fsasm/f1tenth_sensors-interface-board/kicad/ba-imu/3d-001.png

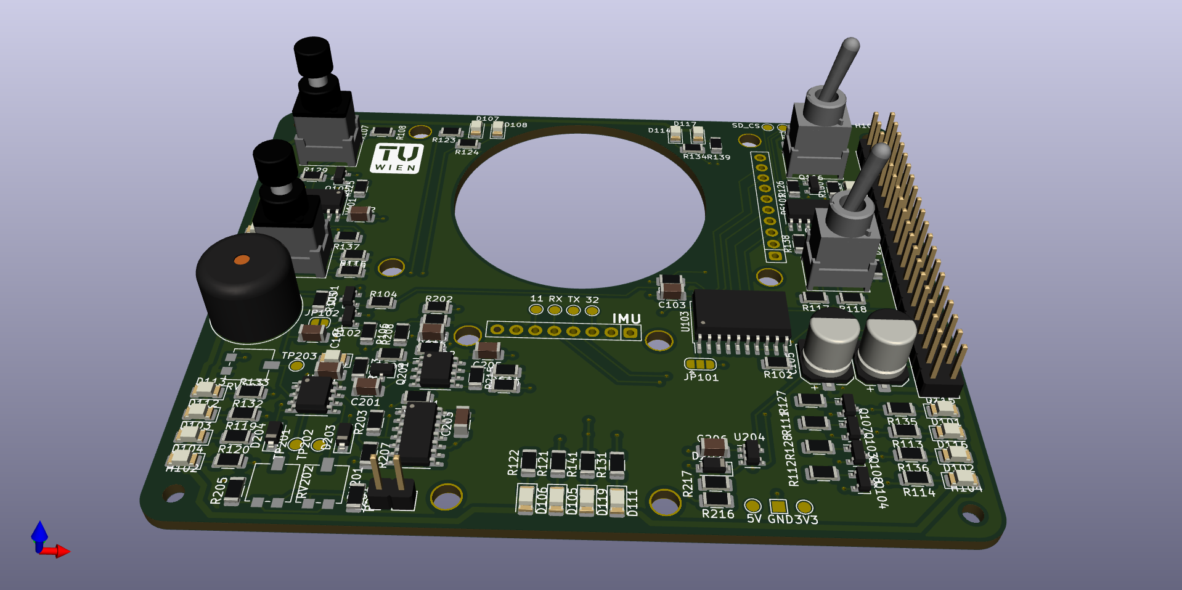
kicad/ba-imu/3d-001.png
