fsasm/f1tenth_sensors-interface-board/README.md

# f1tenth_sensors-interface-board
Extension board for F1tenth cars with sensors and interfaces for humans (LEDs, display, buttons, etc.)
