fsasm/f1tenth_sensors-interface-board/kicad/ba-imu/CFP2-1FC-AW.stp

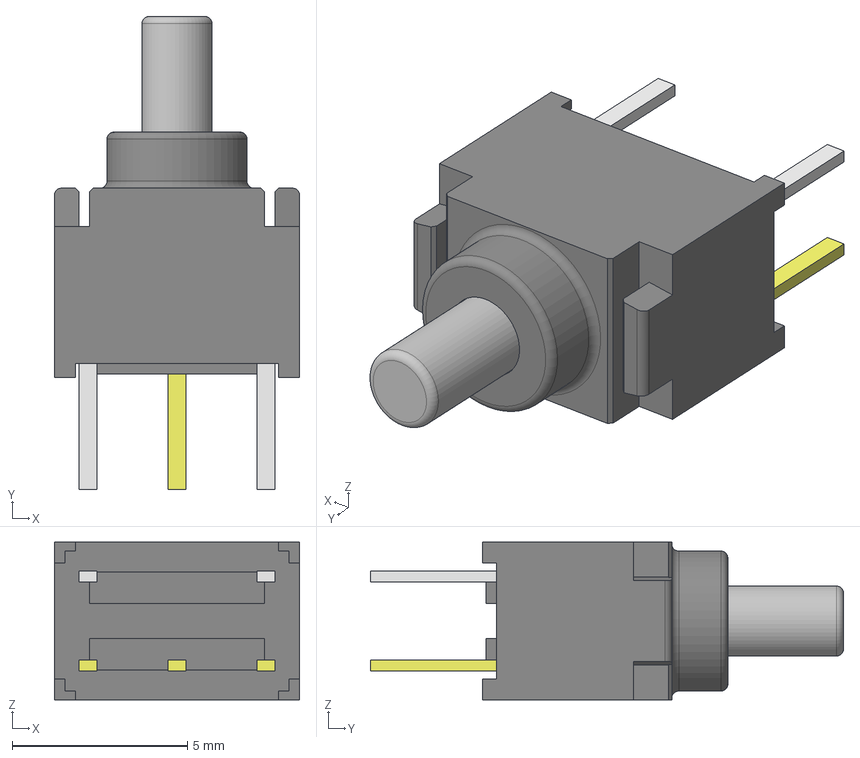
[picture p2: CAD file, 2022-10-10]
kicad/ba-imu/CFP2-1FC-AW.stp
7.00 x 13.5 x 4.50 mm
_2001FP_1_(CFT2)
_3007CFP_push_switch x 3
_3007CFT-2 x 2
_1002CFP-1
