fsasm/f1tenth_sensors-interface-board/kicad/BB15AP-FA.stp

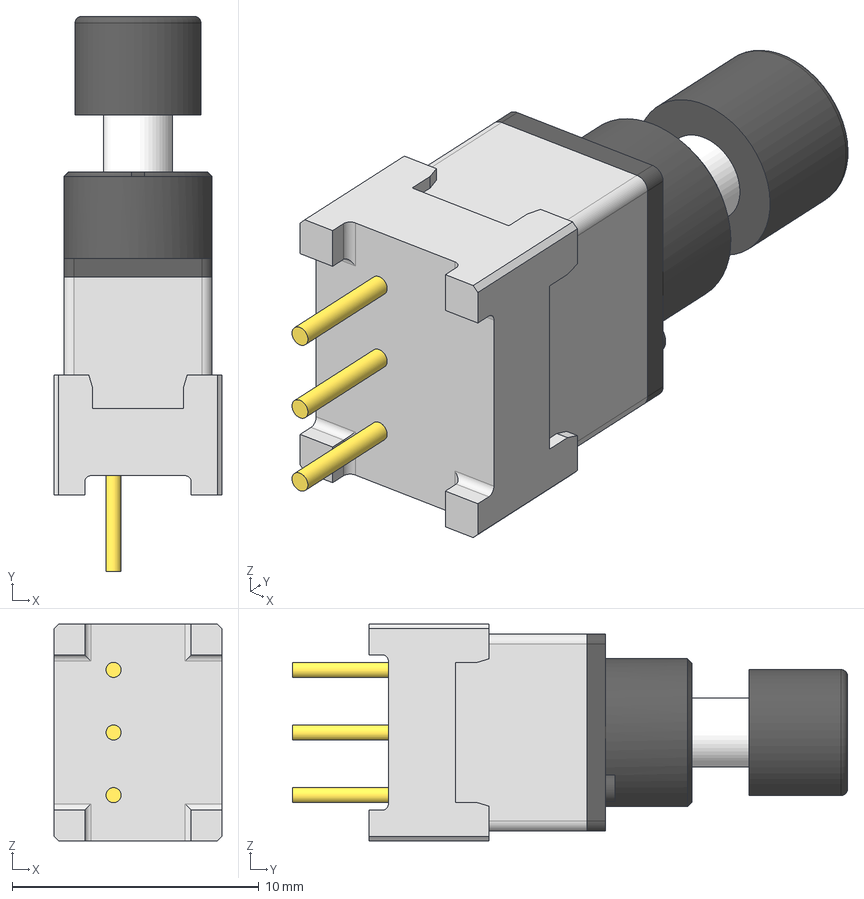
[picture p3: CAD file, 2022-10-10]
kicad/BB15AP-FA.stp
6.81 x 22.5 x 8.79 mm
_BB15-body
_BBA-plunger
_BB15P-terminal
_BB15P-body3
_BB-FA-cap
