fsasm/f1tenth_sensors-interface-board/kicad/B12AP.stp

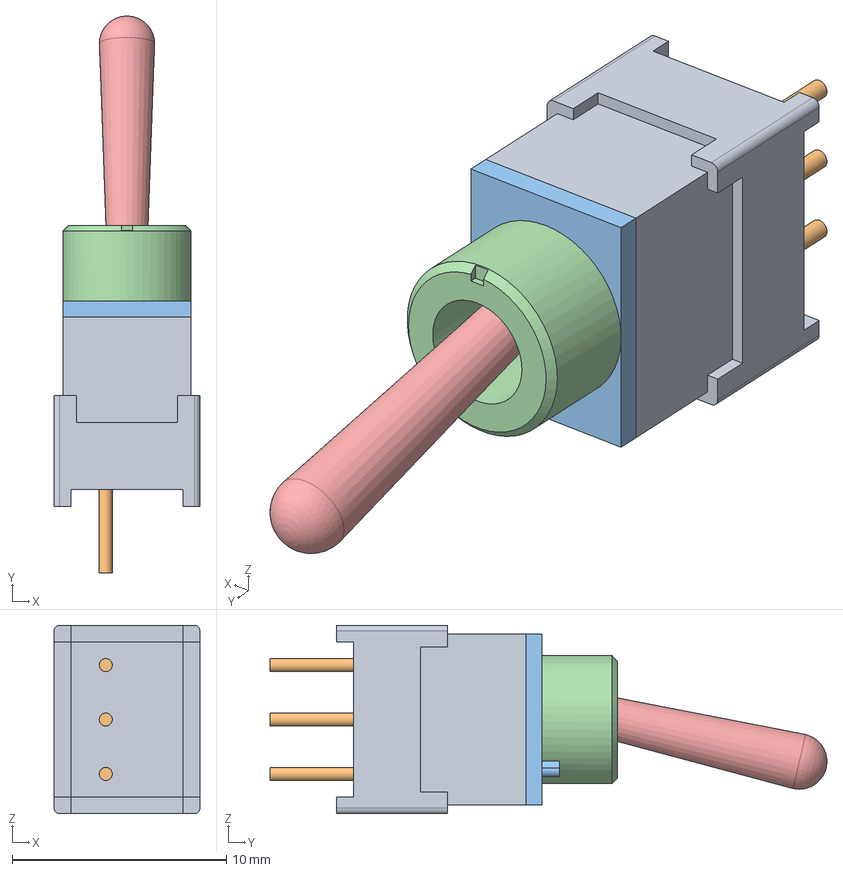
[picture p4: CAD file, 2022-10-10]
kicad/B12AP.stp
6.81 x 26.0 x 8.79 mm
_B12APbody
_B12APtrmnls
_B12APblack
_B12APbtoggl
_B12APtoggle
