fsasm/f1tenth_sensors-interface-board/kicad/ba-imu/CF-LD-1DC-AR2W.stp

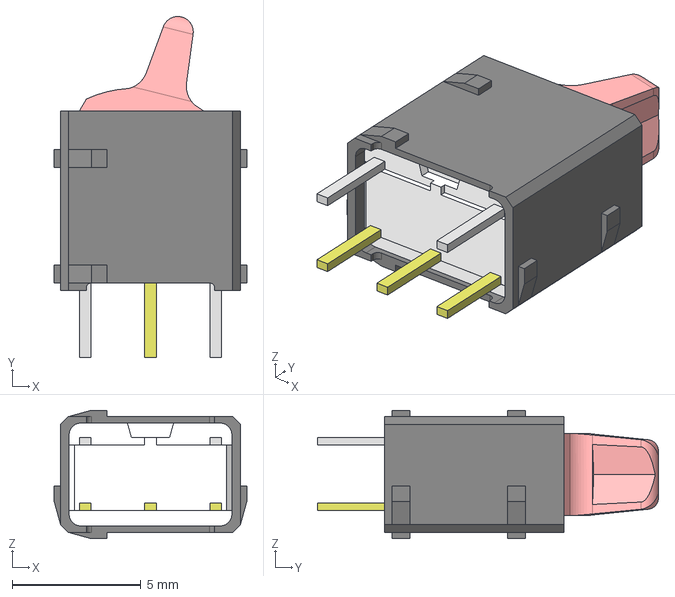
[picture p5: CAD file, 2022-10-10]
kicad/ba-imu/CF-LD-1DC-AR2W.stp
7.50 x 13.3 x 5.00 mm
_CF-LD_body (PC)
_CF-LD_Lever (1.00,0.50,0.50,0.00)
