fsasm/f1tenth_sensors-interface-board/(list of files, cad)

Other CAD files:
kicad/ba-imu/B12AP.stp
