fsasm/f1tenth_sensors-interface-board/kicad/ba-imu/ba-imu.pdf

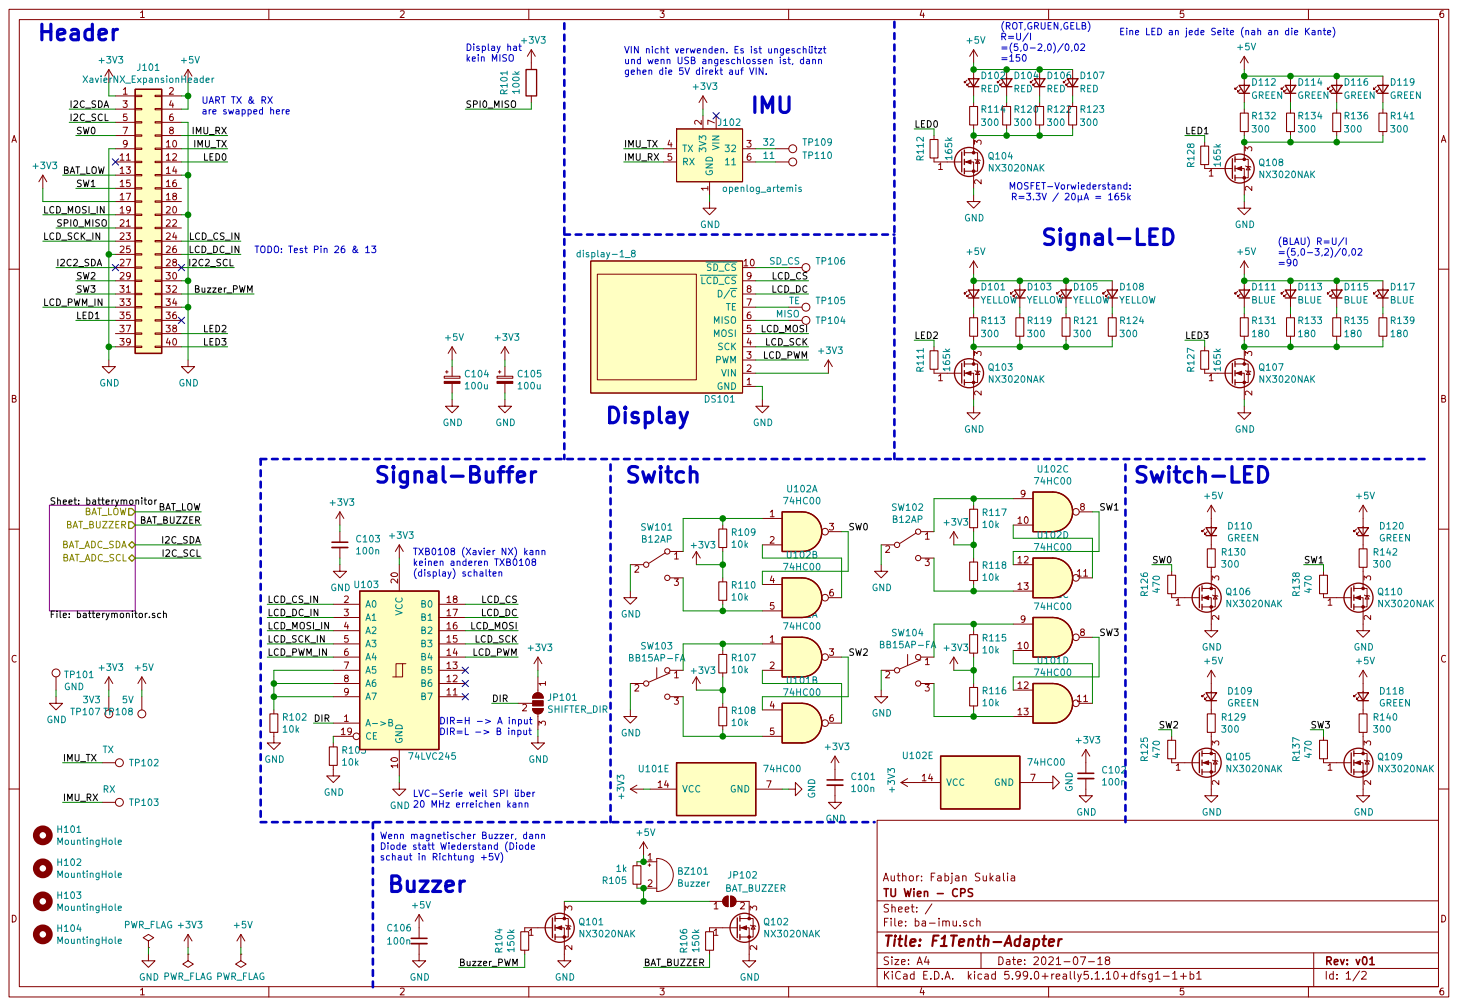
[picture p6: page 1]

Eine LED an jede Seite (nah an die Kante)

VIN nicht verwenden. Es ist ungeschützt
und wenn USB angeschlossen ist, dann
gehen die 5V direkt auf VIN.

=(5,0-3,2)/0,02 =90 TXB0108 (Xavier NX) kann keinen anderen TXB0108

LVC-Serie weil SPI über 20 MHz erreichen kann

Wenn magnetischer Buzzer, dann
Diode statt Wiederstand (Diode
schaut in Richtung +5V)
Buzzer

Author: Fabjan Sukalia
Id: 1/2 Title: F1Tenth-Adapter File: ba-imu.sch Sheet: / TU Wien - CPS

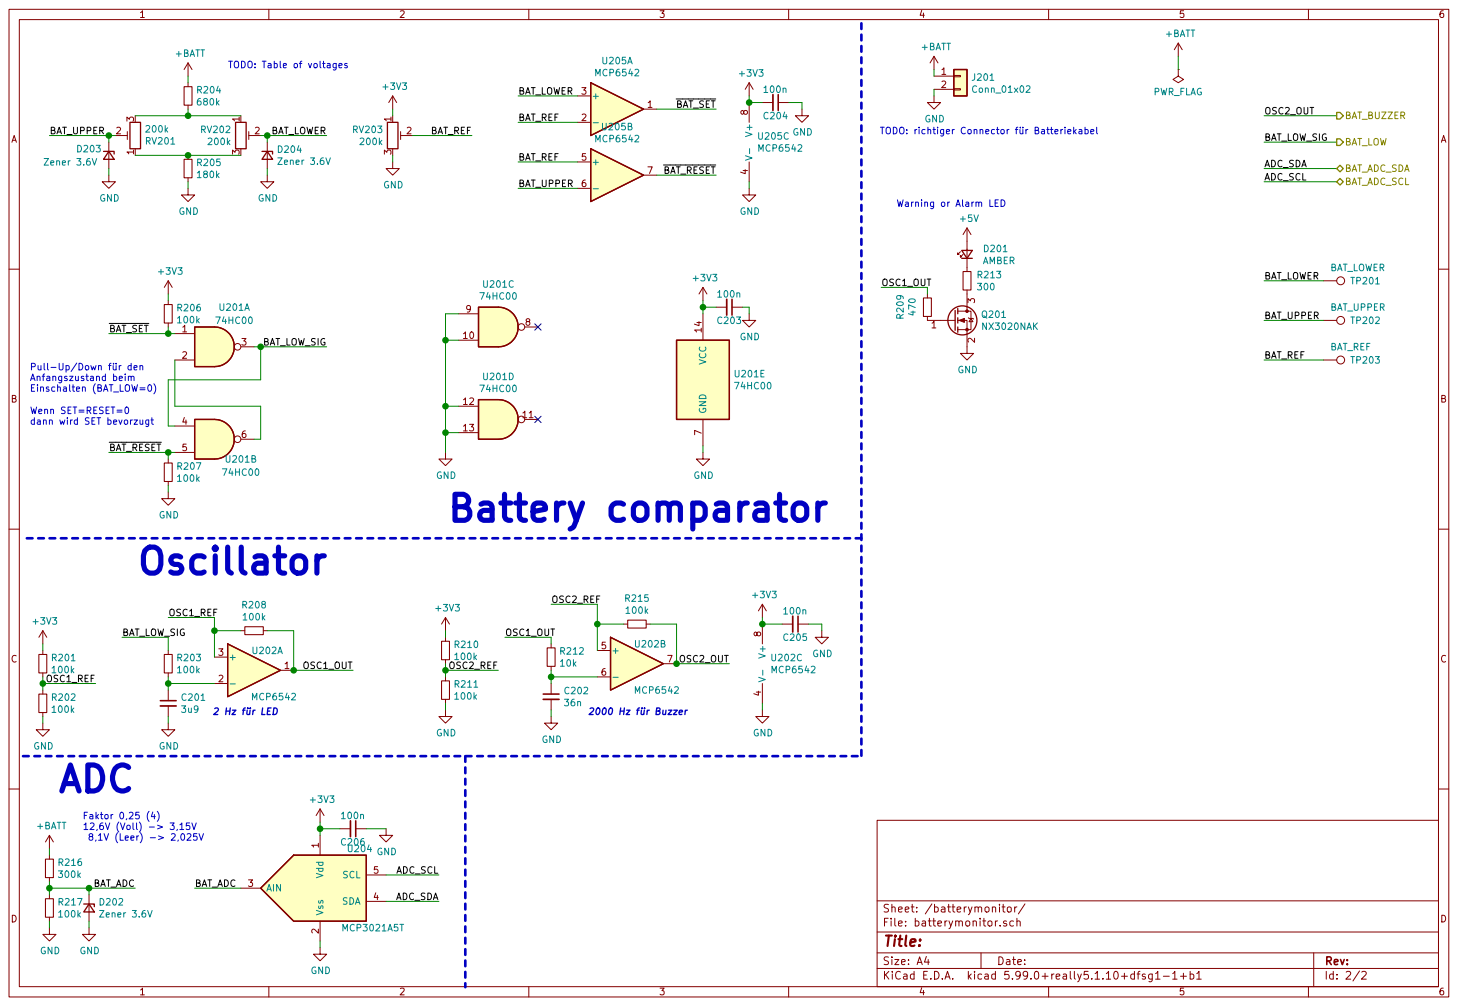
[picture p7: page 2]

TODO: Table of voltages

TODO: richtiger Connector für Batteriekabel

Warning or Alarm LED

Anfangszustand beim
Einschalten (BAT_LOW=0)
Wenn SET=RESET=0
dann wird SET bevorzugt

1 Vss 2 AIN 3 SDA 4 SCL 5 U204 MCP3021A5T
