fsasm/f1tenth_sensors-interface-board/kicad/ba-imu/batterymonitor-batterymonitor.pdf

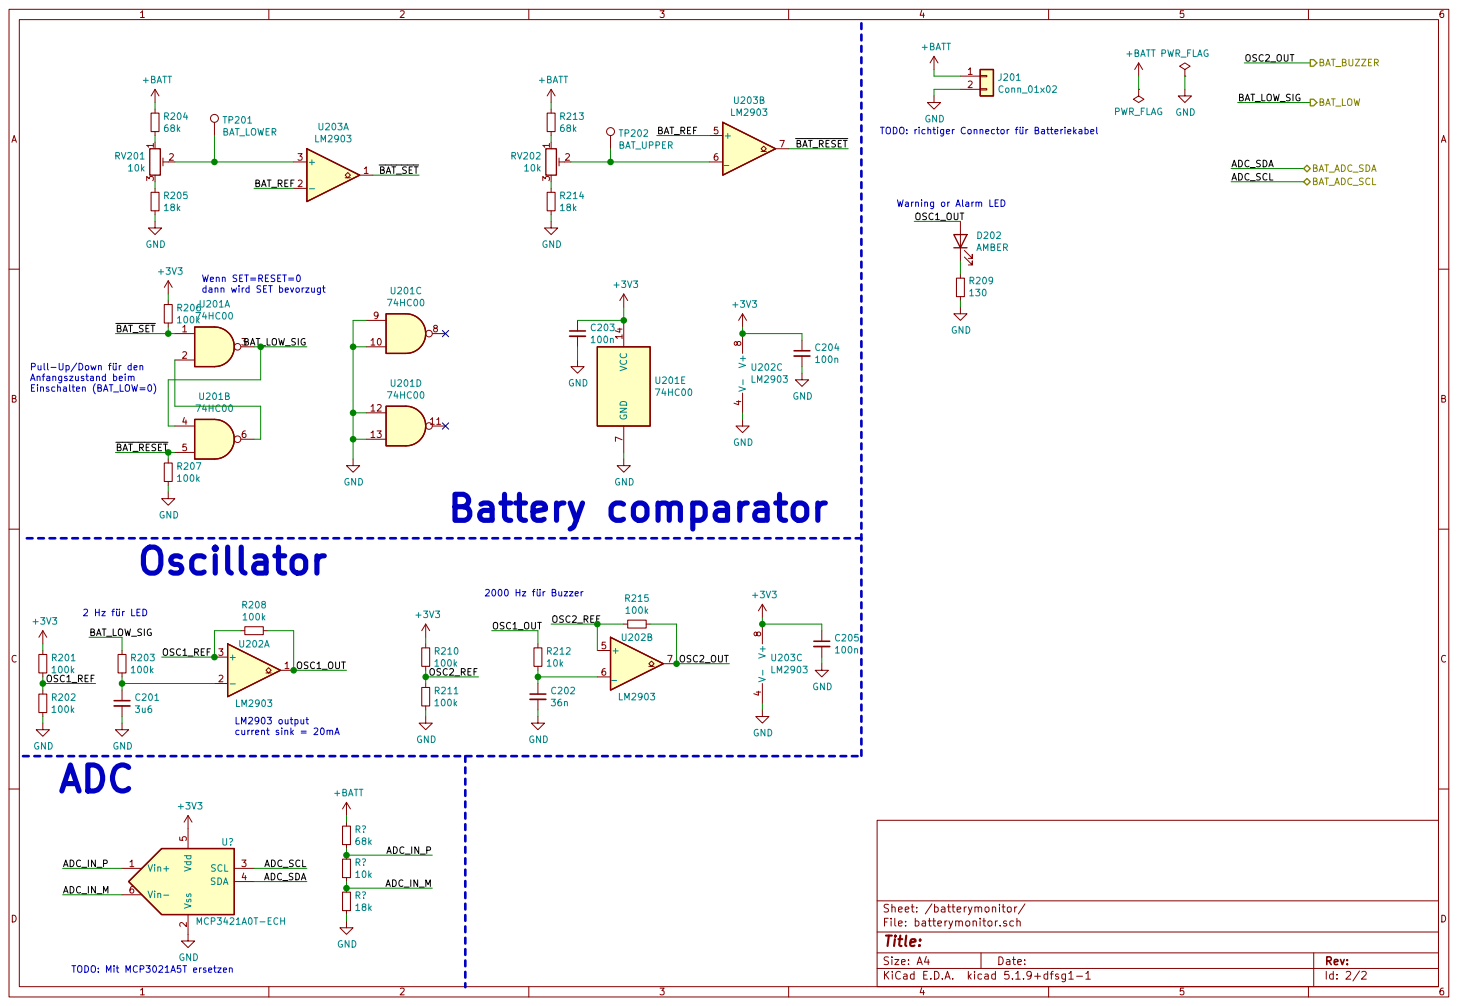
[picture p8: page 1]

TODO: richtiger Connector für Batteriekabel

Warning or Alarm LED

Wenn SET=RESET=0
dann wird SET bevorzugt

2000 Hz für Buzzer Pull-Up/Down für den
Anfangszustand beim
Einschalten (BAT_LOW=0)
