fsasm/f1tenth_sensors-interface-board/kicad/ba-imu/ba-imu.kicad_pcb

## KiCad design kicad/ba-imu/ba-imu.kicad_pcb (2022-10-10)

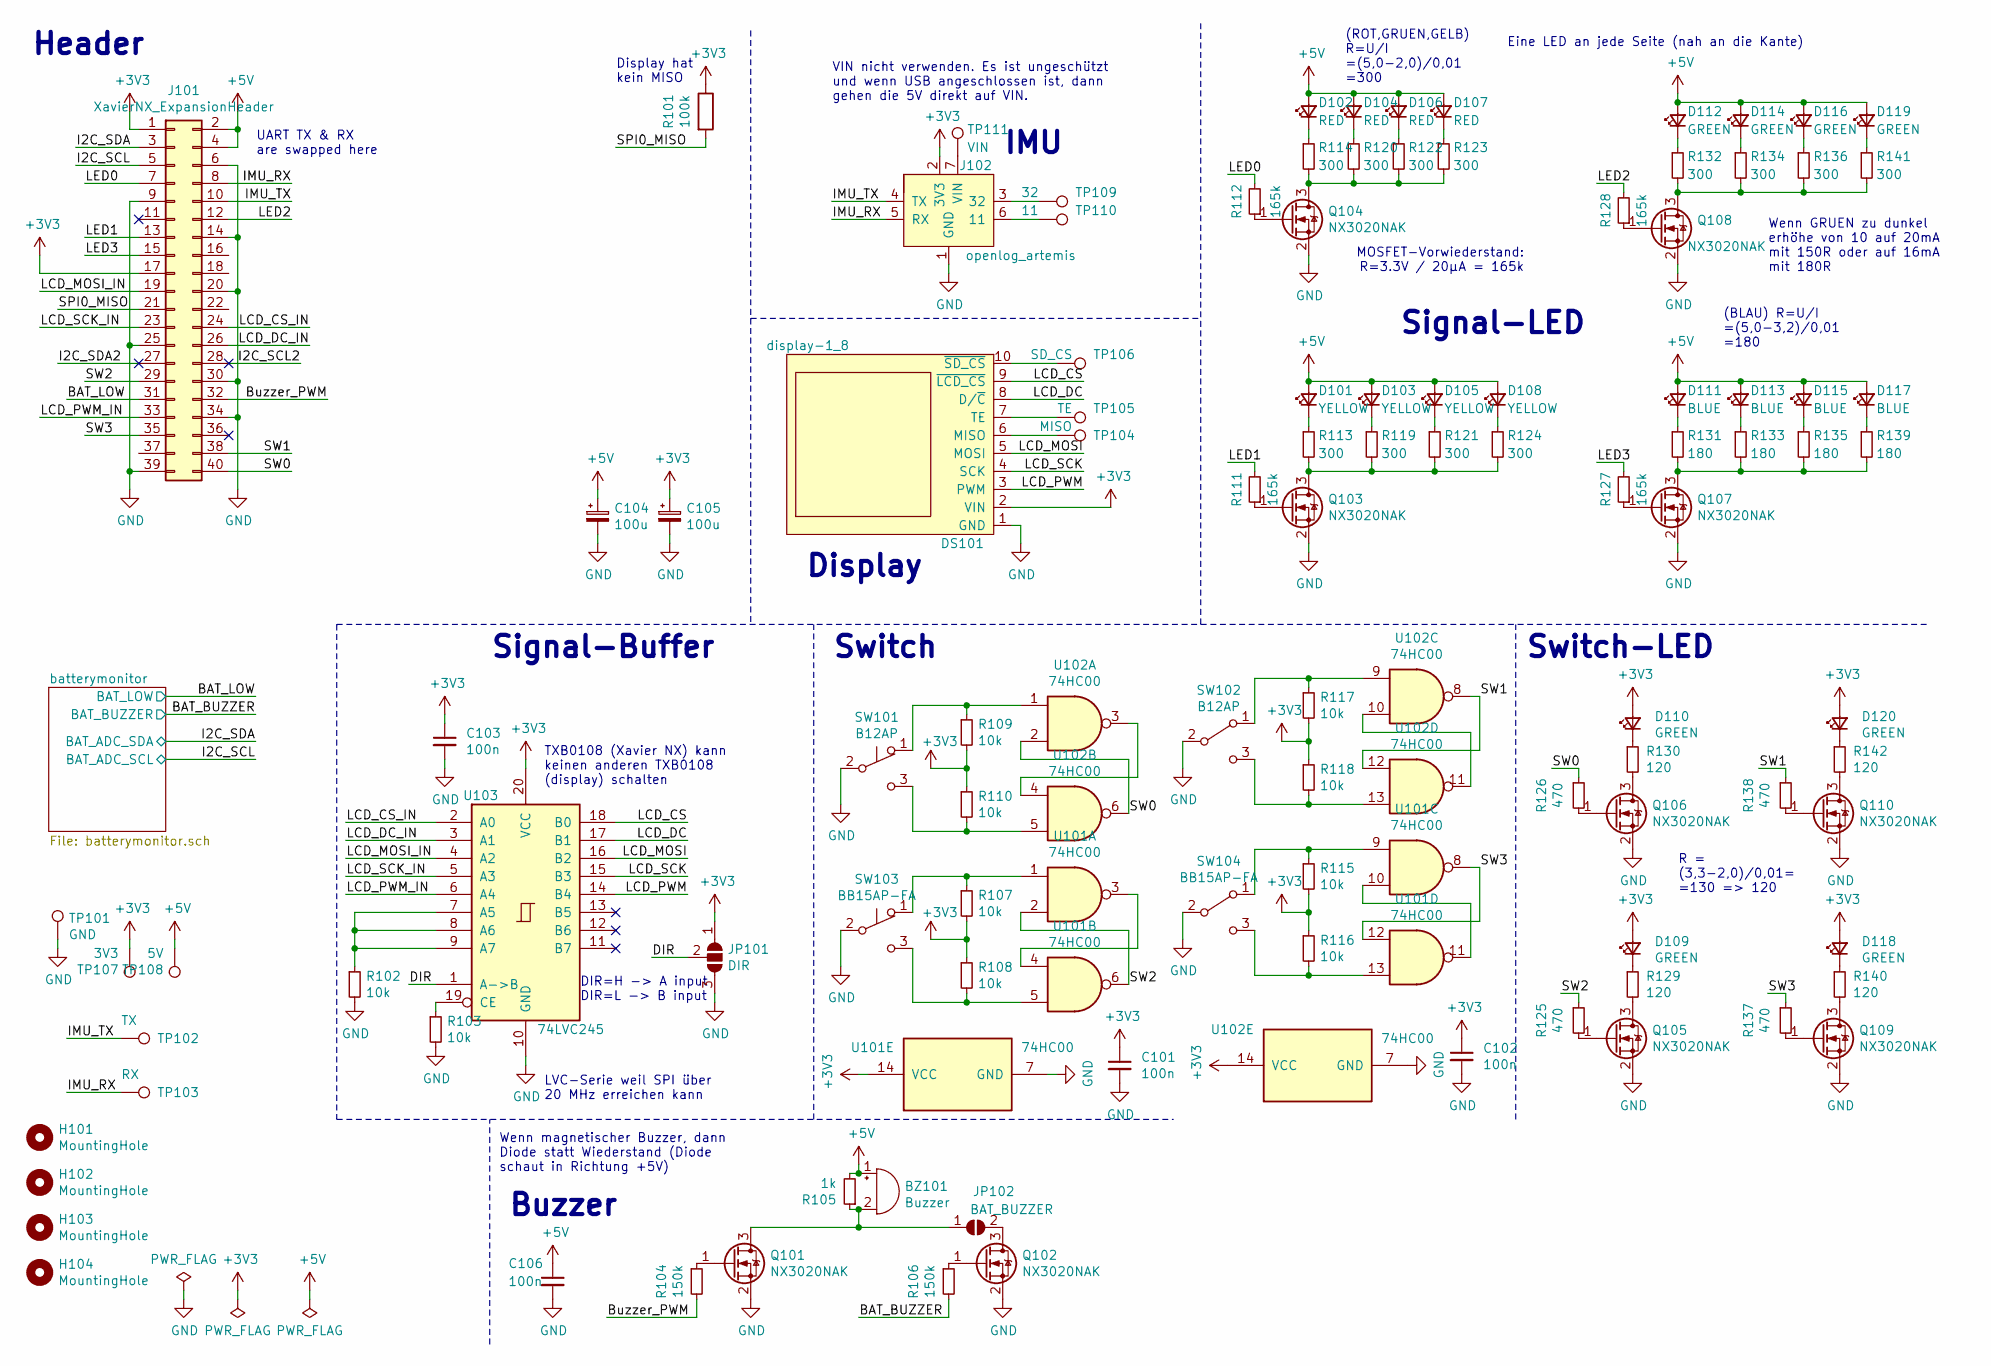
[picture p9: schematic ba-imu.sch, F1Tenth-Adapter]

Parts:
BZ101: Buzzer; Buzzer_TDK_PS1240P02BT_D12.2mm_H6.5mm; MPN PS1240P02BT; Digi-Key PN 445-2525-1-ND
C101, C102, C103, C106: 100n; C_1206_3216Metric
C104, C105: 100u; CP_Elec_6.3x7.7
D101, D103, D105, D108: YELLOW; LED_1206_3216Metric; MPN 156120YS75000; Digi-Key PN 732-5034-1-ND
D102, D104, D106, D107: RED; LED_1206_3216Metric; MPN 156120RS75000; Digi-Key PN 732-5030-1-ND
D109, D110, D112, D114, D116, D118, D119, D120: GREEN; LED_1206_3216Metric; MPN HSMQ-C150; Digi-Key PN 516-1444-1-ND
D111, D113, D115, D117: BLUE; LED_1206_3216Metric; MPN 156125BS75000; Digi-Key PN 732-13392-1-ND
DS101: display-1_8; display_SIP-10
H101, H102, H103, H104: MountingHole; MountingHole_2.5mm
J101: XavierNX_ExpansionHeader; PinHeader_2x20_P2.54mm_Vertical
J102: openlog_artemis; imu_SIP-7
JP101: DIR; SolderJumper-3_P1.3mm_Open_RoundedPad1.0x1.5mm
JP102: BAT_BUZZER; SolderJumper-2_P1.3mm_Open_RoundedPad1.0x1.5mm
Q101, Q102, Q103, Q104, Q105, Q106, Q107, Q108, Q109, Q110: NX3020NAK; SOT-23; MPN NX3020NAK; Digi-Key PN 1727-1285-1-ND
R101: 100k; R_1206_3216Metric
R102, R103, R107, R108, R109, R110, R115, R116, R117, R118: 10k; R_1206_3216Metric
R104, R106: 150k; R_1206_3216Metric
R105: 1k; R_1206_3216Metric
R111, R112, R127, R128: 165k; R_1206_3216Metric
R113, R114, R119, R120, R121, R122, R123, R124, R132, R134, R136, R141: 300; R_1206_3216Metric
R125, R126, R137, R138: 470; R_1206_3216Metric
R129, R130, R140, R142: 120; R_1206_3216Metric
R131, R133, R135, R139: 180; R_1206_3216Metric
SW101: B12AP; SW_Nidec_CFP2-1FC-AW; MPN B12AP; Digi-Key PN 360-1012-ND
SW102: B12AP; SW_Nidec_CF-LD-1DC-AR2W; MPN B12AP; Digi-Key PN 360-1012-ND
SW103: BB15AP-FA; SW_Nidec_CFP2-1FC-AW; MPN BB15AP-FA; Digi-Key PN 360-3753-ND
SW104: BB15AP-FA; SW_Nidec_CF-LD-1DC-AR2W; MPN BB15AP-FA; Digi-Key PN 360-3753-ND
TP101: GND; TestPoint_Pad_1.5x1.5mm
TP102: TX; TestPoint_Pad_D1.5mm
TP103: RX; TestPoint_Pad_D1.5mm
TP104: MISO; TestPoint_Pad_D1.5mm
TP105: TE; TestPoint_Pad_D1.5mm
TP106: SD_CS; TestPoint_Pad_D1.5mm
TP107: 3V3; TestPoint_Pad_D1.5mm
TP108: 5V; TestPoint_Pad_D1.5mm
TP109: 32; TestPoint_Pad_D1.5mm
TP110: 11; TestPoint_Pad_D1.5mm
TP111: VIN; TestPoint_Pad_D1.5mm
U101, U102: 74HC00; SOIC-14_3.9x8.7mm_P1.27mm; MPN SN74HC00DE4; Digi-Key PN 296-52930-ND
U103: 74LVC245; SOIC-20W_7.5x12.8mm_P1.27mm; MPN SN74LVC245ADW; Digi-Key PN 296-1232-5-ND

Connections:
+3V3: C101.1, C102.1, C103.1, C105.1, D109.2 (A), D110.2 (A), D118.2 (A), D120.2 (A), DS101.2 (VIN), J101.1, J101.17, J102.2 (3V3), JP101.1 (A), R101.1, R107.2, R108.1, R109.2, R110.1, R115.2, R116.1, R117.2, R118.1, TP107.1, U101.14 (VCC), U102.14 (VCC), U103.20 (VCC); also elsewhere on the board
+5V: BZ101.1 (-), C104.1, C106.1, D101.2 (A), D102.2 (A), D103.2 (A), D104.2 (A), D105.2 (A), D106.2 (A), D107.2 (A), D108.2 (A), D111.2 (A), D112.2 (A), D113.2 (A), D114.2 (A), D115.2 (A), D116.2 (A), D117.2 (A), D119.2 (A), J101.2, J101.4, R105.2, TP108.1
/BAT_BUZZER: R106.2; also elsewhere on the board
/BAT_LOW: J101.31; also elsewhere on the board
/Buzzer_PWM: J101.32, R104.2
/DIR: JP101.2 (C), U103.1 (A->B)
/I2C_SCL: J101.5; also elsewhere on the board
/I2C_SCL2: J101.28
/I2C_SDA: J101.3; also elsewhere on the board
/I2C_SDA2: J101.27
/IMU_RX: J101.8, J102.5 (RX), TP103.1
/IMU_TX: J101.10, J102.4 (TX), TP102.1
/LCD_CS: DS101.9 (~LCD_CS), U103.18 (B0)
/LCD_CS_IN: J101.24, U103.2 (A0)
/LCD_DC: DS101.8 (D/~C), U103.17 (B1)
/LCD_DC_IN: J101.26, U103.3 (A1)
/LCD_MOSI: DS101.5 (MOSI), U103.16 (B2)
/LCD_MOSI_IN: J101.19, U103.4 (A2)
/LCD_PWM: DS101.3 (PWM), U103.14 (B4)
/LCD_PWM_IN: J101.33, U103.6 (A4)
/LCD_SCK: DS101.4 (SCK), U103.15 (B3)
/LCD_SCK_IN: J101.23, U103.5 (A3)
/LED0: J101.7, R112.2
/LED1: J101.13, R111.2
/LED2: J101.12, R128.2
/LED3: J101.15, R127.2
/SPI0_MISO: J101.21, R101.2
/SW0: J101.40, R126.1, U102.2, U102.6
/SW1: J101.38, R138.1, U102.8, U102.12
/SW2: J101.29, R125.1, U101.2, U101.6
/SW3: J101.35, R137.1, U101.8, U101.12
GND: C101.2, C102.2, C103.2, C104.2, C105.2, C106.2, DS101.1 (GND), J101.6, J101.9, J101.14, J101.20, J101.25, J101.30, J101.34, J101.39, J102.1 (GND), JP101.3 (B), Q101.2 (S), Q102.2 (S), Q103.2 (S), Q104.2 (S), Q105.2 (S), Q106.2 (S), Q107.2 (S), Q108.2 (S), Q109.2 (S), Q110.2 (S), R102.2, R103.2, SW101.2 (B), SW102.2 (B), SW103.2 (B), SW104.2 (B), TP101.1, U101.7 (GND), U102.7 (GND), U103.10 (GND); also elsewhere on the board
unnamed: BZ101.2 (+), JP102.1 (A), Q101.3 (D), R105.1
unnamed: D101.1 (K), R113.1
unnamed: D102.1 (K), R114.1
unnamed: D103.1 (K), R119.1
unnamed: D104.1 (K), R120.1
unnamed: D105.1 (K), R121.1
unnamed: D106.1 (K), R122.1
unnamed: D107.1 (K), R123.1
unnamed: D108.1 (K), R124.1
unnamed: D109.1 (K), R129.1
unnamed: D110.1 (K), R130.1
unnamed: D111.1 (K), R131.1
unnamed: D112.1 (K), R132.1
unnamed: D113.1 (K), R133.1
unnamed: D114.1 (K), R134.1
unnamed: D115.1 (K), R135.1
unnamed: D116.1 (K), R136.1
unnamed: D117.1 (K), R139.1
unnamed: D118.1 (K), R140.1
unnamed: D119.1 (K), R141.1
unnamed: D120.1 (K), R142.1
unnamed: DS101.6 (MISO), TP104.1
unnamed: DS101.7 (TE), TP105.1
unnamed: DS101.10 (~SD_CS), TP106.1
unnamed: J102.3 (32), TP109.1
unnamed: J102.6 (11), TP110.1
unnamed: J102.7 (VIN), TP111.1
unnamed: JP102.2 (B), Q102.3 (D)
unnamed: Q101.1 (G), R104.1
unnamed: Q102.1 (G), R106.1
unnamed: Q103.1 (G), R111.1
unnamed: Q103.3 (D), R113.2, R119.2, R121.2, R124.2
unnamed: Q104.1 (G), R112.1
unnamed: Q104.3 (D), R114.2, R120.2, R122.2, R123.2
unnamed: Q105.1 (G), R125.2
unnamed: Q105.3 (D), R129.2
unnamed: Q106.1 (G), R126.2
unnamed: Q106.3 (D), R130.2
unnamed: Q107.1 (G), R127.1
unnamed: Q107.3 (D), R131.2, R133.2, R135.2, R139.2
unnamed: Q108.1 (G), R128.1
unnamed: Q108.3 (D), R132.2, R134.2, R136.2, R141.2
unnamed: Q109.1 (G), R137.2
unnamed: Q109.3 (D), R140.2
unnamed: Q110.1 (G), R138.2
unnamed: Q110.3 (D), R142.2
unnamed: R102.1, U103.7 (A5), U103.8 (A6), U103.9 (A7)
unnamed: R103.1, U103.19 (CE)
unnamed: R107.1, SW103.1 (A), U101.1
unnamed: R108.2, SW103.3 (C), U101.5
unnamed: R109.1, SW101.1 (A), U102.1
unnamed: R110.2, SW101.3 (C), U102.5
unnamed: R115.1, SW104.1 (A), U101.9
unnamed: R116.2, SW104.3 (C), U101.13
unnamed: R117.1, SW102.1 (A), U102.9
unnamed: R118.2, SW102.3 (C), U102.13
unnamed: U101.3, U101.4
unnamed: U101.10, U101.11
unnamed: U102.3, U102.4
unnamed: U102.10, U102.11

Notes on the sheet:
(ROT,GRUEN,GELB) R=U/I =(5,0-2,0)/0,01 =300
Wenn magnetischer Buzzer, dann Diode statt Wiederstand (Diode schaut in Richtung +5V)
VIN nicht verwenden. Es ist ungeschützt und wenn USB angeschlossen ist, dann gehen die 5V direkt auf VIN.
Eine LED an jede Seite (nah an die Kante)
DIR=H -> A input DIR=L -> B input
TXB0108 (Xavier NX) kann keinen anderen TXB0108 (display) schalten
(BLAU) R=U/I =(5,0-3,2)/0,01 =180
UART TX & RX are swapped here
Switch-LED
Switch
Buzzer
Signal-LED
LVC-Serie weil SPI über 20 MHz erreichen kann
Signal-Buffer
IMU
Display
Header
Display hat kein MISO
R = (3,3-2,0)/0,01= =130 => 120
Wenn GRUEN zu dunkel erhöhe von 10 auf 20mA mit 150R oder auf 16mA mit 180R
MOSFET-Vorwiederstand: R=3.3V / 20µA = 165k

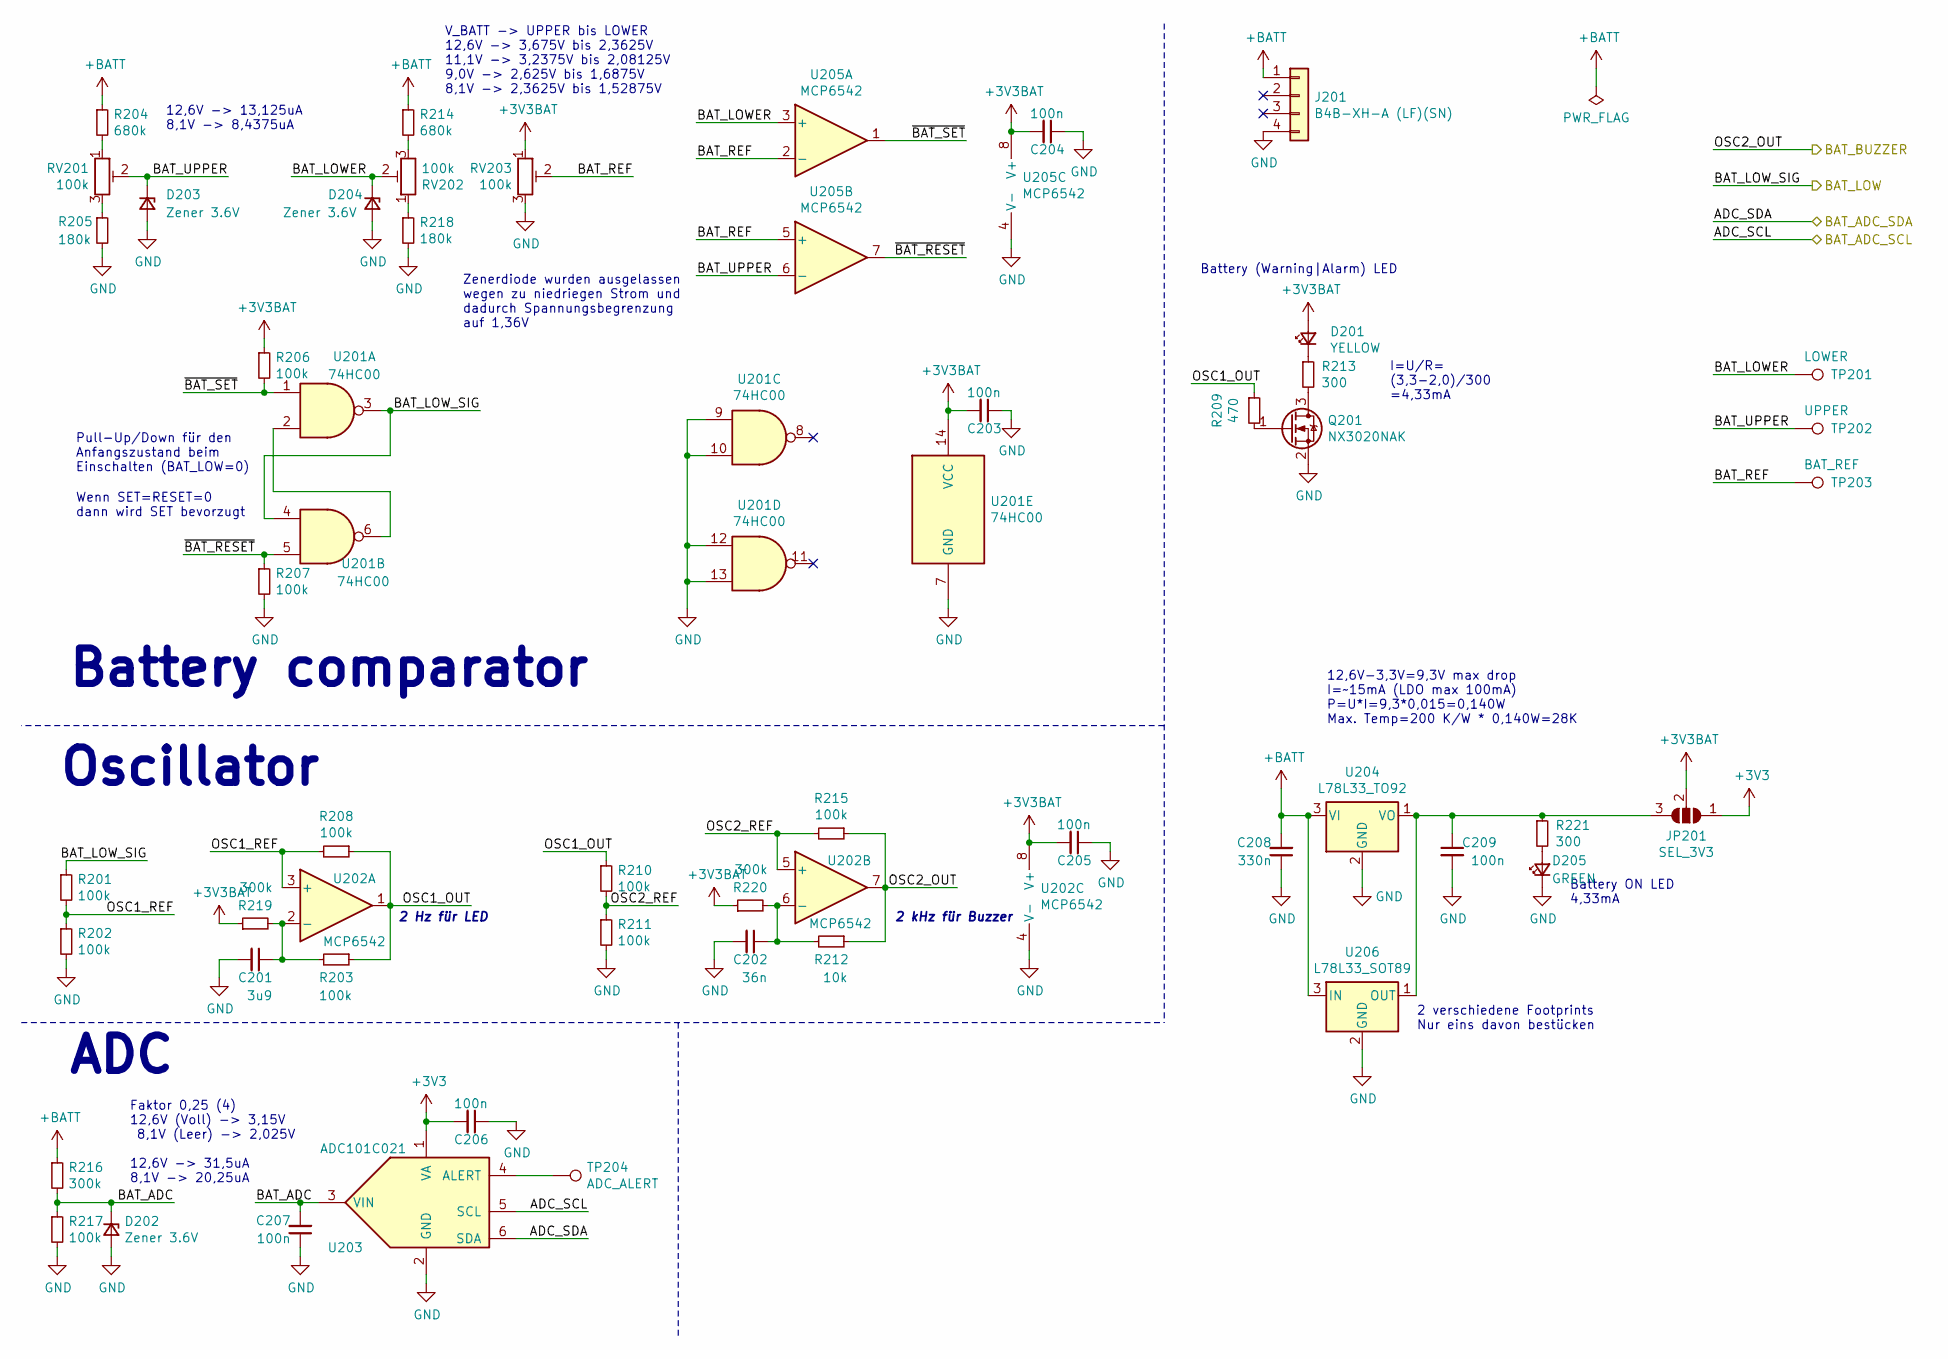
[picture p10: schematic batterymonitor.sch]

Parts:
C201: 3u9; C_1206_3216Metric
C202: 36n; C_1206_3216Metric
C203, C204, C205, C206, C207, C209: 100n; C_1206_3216Metric
C208: 330n; C_1206_3216Metric
D201: YELLOW; LED_1206_3216Metric; MPN 156120YS75000; Digi-Key PN 732-5034-1-ND
D202, D203, D204: Zener 3.6V; D_SOD-123; MPN MMSZ5227B-TP; Mouser PN 833-MMSZ5227B-TP
D205: GREEN; LED_1206_3216Metric; MPN 156120YS75000; Digi-Key PN 732-5034-1-ND
J201: B4B-XH-A (LF)(SN); JST_XH_B4B-XH-A_1x04_P2.50mm_Vertical; MPN B4B-XH-A(LF)(SN); Digi-Key PN 455-2249-ND
JP201: SEL_3V3; SolderJumper-3_P1.3mm_Open_RoundedPad1.0x1.5mm
Q201: NX3020NAK; SOT-23; MPN NX3020NAK; Digi-Key PN 1727-1285-1-ND
R201, R202, R203, R206, R207, R208, R210, R211, R215, R217: 100k; R_1206_3216Metric
R204, R214: 680k; R_1206_3216Metric
R205, R218: 180k; R_1206_3216Metric
R209: 470; R_1206_3216Metric
R212: 10k; R_1206_3216Metric
R213, R221: 300; R_1206_3216Metric
R216, R219, R220: 300k; R_1206_3216Metric
RV201, RV202, RV203: 100k; Potentiometer_Vishay_TS53YL_Vertical; MPN TS53YL204MR10; Digi-Key PN TS53YL-200KCT-ND
TP201: LOWER; TestPoint_Pad_D1.5mm
TP202: UPPER; TestPoint_Pad_D1.5mm
TP203: BAT_REF; TestPoint_Pad_D1.5mm
TP204: ADC_ALERT; TestPoint_Pad_D1.5mm
U201: 74HC00; SOIC-14_3.9x8.7mm_P1.27mm; MPN SN74HC00DE4; Digi-Key PN 296-52930-ND
U202, U205: MCP6542; SOIC-8_3.9x4.9mm_P1.27mm; MPN MCP6542-I/SN; Digi-Key PN MCP6542-I/SN-ND
U203: ADC101C021; SOT-23-6
U204: L78L33_TO92; TO-92_Inline
U206: L78L33_SOT89; SOT-89-3

Connections:
+3V3: C206.2, JP201.1 (A), U203.1 (VA); also elsewhere on the board
+3V3BAT: C203.2, C204.2, C205.2, D201.2 (A), JP201.2 (C), R206.1, R219.1, R220.1, RV203.1, U201.14 (VCC), U202.8 (V+), U205.8 (V+)
+BATT: C208.2, J201.1, R204.1, R214.1, R216.1, U204.3 (VI), U206.3 (IN)
/BAT_BUZZER: R212.1, R215.1, U202.7; also elsewhere on the board
/BAT_LOW: R201.1, U201.3, U201.4; also elsewhere on the board
/I2C_SCL: U203.5 (SCL); also elsewhere on the board
/I2C_SDA: U203.6 (SDA); also elsewhere on the board
/batterymonitor/BAT_ADC: C207.2, D202.1 (K), R216.2, R217.1, U203.3 (VIN)
/batterymonitor/BAT_LOWER: D204.1 (K), RV202.2, TP201.1, U205.3 (+)
/batterymonitor/BAT_REF: RV203.2, TP203.1, U205.2 (-), U205.5 (+)
/batterymonitor/BAT_UPPER: D203.1 (K), RV201.2, TP202.1, U205.6 (-)
/batterymonitor/OSC1_OUT: R203.1, R208.1, R209.1, R210.1, U202.1
/batterymonitor/OSC1_REF: R201.2, R202.1, R208.2, U202.3 (+)
/batterymonitor/OSC2_REF: R210.2, R211.1, R215.2, U202.5 (+)
/batterymonitor/~BAT_RESET: R207.1, U201.5, U205.7
/batterymonitor/~BAT_SET: R206.2, U201.1, U205.1
GND: C201.2, C202.2, C203.1, C204.1, C205.1, C206.1, C207.1, C208.1, C209.2, D202.2 (A), D203.2 (A), D204.2 (A), D205.1 (K), J201.4, Q201.2 (S), R202.2, R205.2, R207.2, R211.2, R217.2, R218.2, RV203.3, U201.7 (GND), U201.9, U201.10, U201.12, U201.13, U202.4 (V-), U203.2 (GND), U204.2 (GND), U205.4 (V-), U206.2 (GND); also elsewhere on the board
unnamed: C201.1, R203.2, R219.2, U202.2 (-)
unnamed: C202.1, R212.2, R220.2, U202.6 (-)
unnamed: C209.1, JP201.3 (B), R221.1, U204.1 (VO), U206.1 (OUT)
unnamed: D201.1 (K), R213.1
unnamed: D205.2 (A), R221.2
unnamed: Q201.1 (G), R209.2
unnamed: Q201.3 (D), R213.2
unnamed: R204.2, RV201.1
unnamed: R205.1, RV201.3
unnamed: R214.2, RV202.3
unnamed: R218.1, RV202.1
unnamed: TP204.1, U203.4 (ALERT)
unnamed: U201.2, U201.6

Notes on the sheet:
Pull-Up/Down für den Anfangszustand beim Einschalten (BAT_LOW=0)
Battery comparator
Oscillator
Wenn SET=RESET=0 dann wird SET bevorzugt
2 kHz für Buzzer
Battery (Warning|Alarm) LED
ADC
Faktor 0,25 (4) 12,6V (Voll) -> 3,15V 8,1V (Leer) -> 2,025V 12,6V -> 31,5uA 8,1V -> 20,25uA
V_BATT -> UPPER bis LOWER 12,6V -> 3,675V bis 2,3625V 11,1V -> 3,2375V bis 2,08125V 9,0V -> 2,625V bis 1,6875V 8,1V -> 2,3625V bis 1,52875V
2 Hz für LED
12,6V -> 13,125uA 8,1V -> 8,4375uA
Zenerdiode wurden ausgelassen wegen zu niedriegen Strom und dadurch Spannungsbegrenzung auf 1,36V
Battery ON LED 4,33mA
I=U/R= (3,3-2,0)/300 =4,33mA
2 verschiedene Footprints Nur eins davon bestücken
12,6V-3,3V=9,3V max drop I=~~15mA (LDO max 100mA) P=U*I=9,3*0,015=0,140W Max. Temp=200 K/W * 0,140W=28K

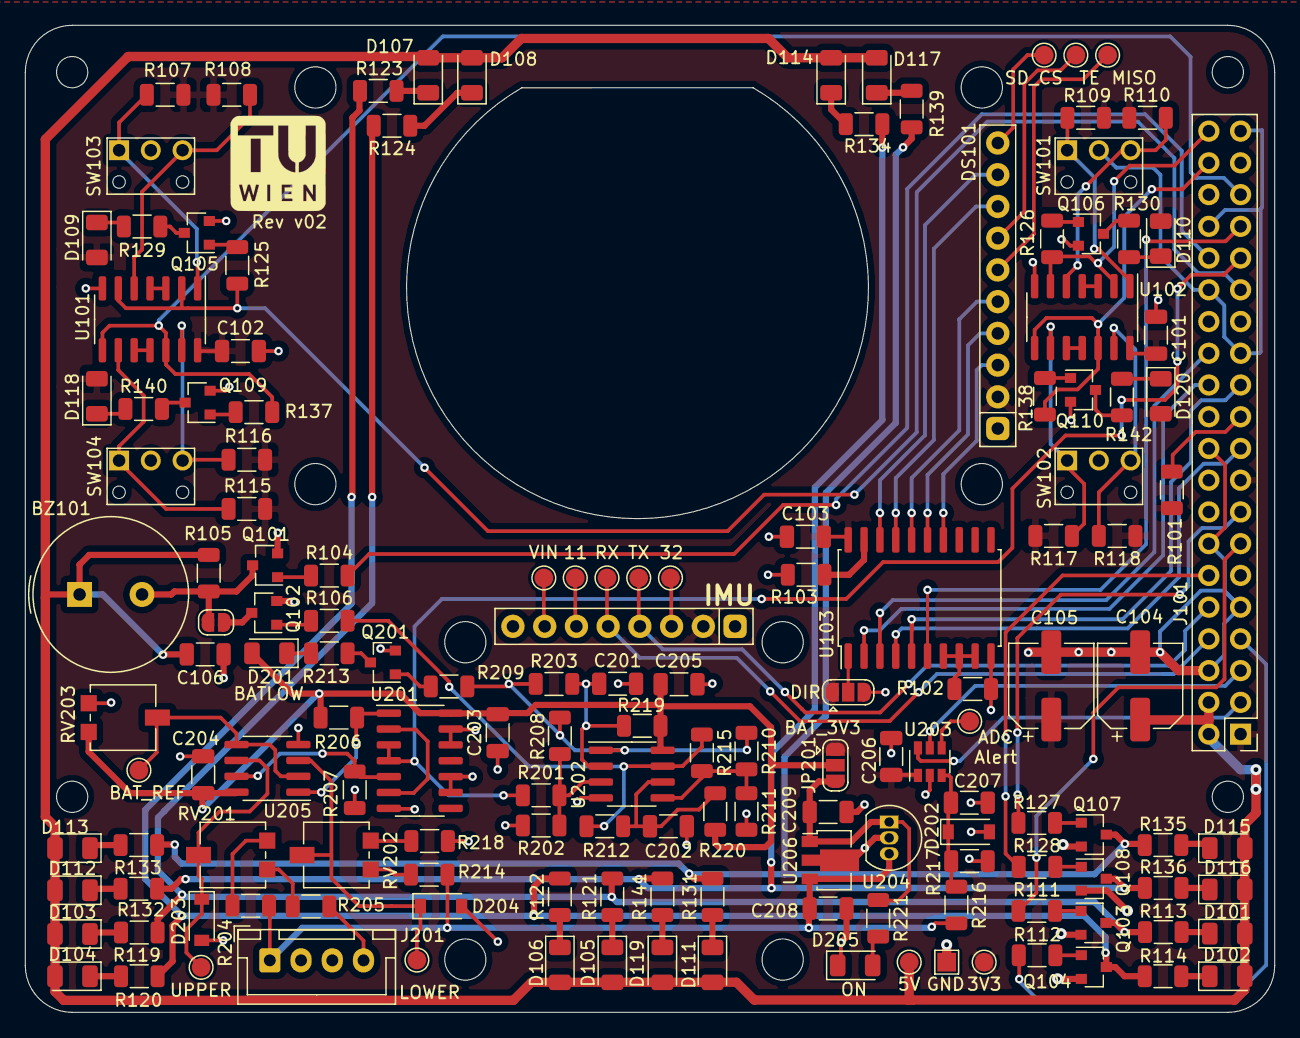
[picture p11: board ba-imu.kicad_pcb from above]

Board: 2 copper layers, 100.0 x 79.0 mm, 157 parts (0 on the bottom side), 114 nets.
