fsasm/f1tenth_sensors-interface-board/(notices)

Notices in the files:
kicad/ba-imu/CFP2-1FC-AW.stp:
FILE_NAME( 'e:/temp/worker_330/temp/exporttempdir_2896_7_36HFv/format_0/CFP2-1FC-AW.stp', '2021-10-28T17:58:58', ( 'License CC BY-ND 4.0' ), ( 'CADENAS' ), ' ', 'PARTsolutions', ' ' );
kicad/BB15AP-FA.stp:
FILE_NAME( 'e:/temp/worker_110/temp/exporttempdir_5892_1279_XzkCv/format_0/BB15AP-FA.stp', '2021-10-19T21:41:38', ( 'License CC BY-ND 4.0' ), ( 'CADENAS' ), ' ', 'PARTsolutions', ' ' );
kicad/B12AP.stp:
FILE_NAME( 'e:/temp/worker_133/temp/exporttempdir_836_30_1QaUT/format_0/B12AP.stp', '2021-10-19T20:42:55', ( 'License CC BY-ND 4.0' ), ( 'CADENAS' ), ' ', 'PARTsolutions', ' ' );
kicad/ba-imu/CF-LD-1DC-AR2W.stp:
FILE_NAME( 'e:/temp/worker_330/temp/exporttempdir_2896_8_UqVKD/format_0/CF-LD-1DC-AR2W.stp', '2021-10-28T17:59:08', ( 'License CC BY-ND 4.0' ), ( 'CADENAS' ), ' ', 'PARTsolutions', ' ' );
